lfc7/drameBOX/export/drameBOX_sch.pdf

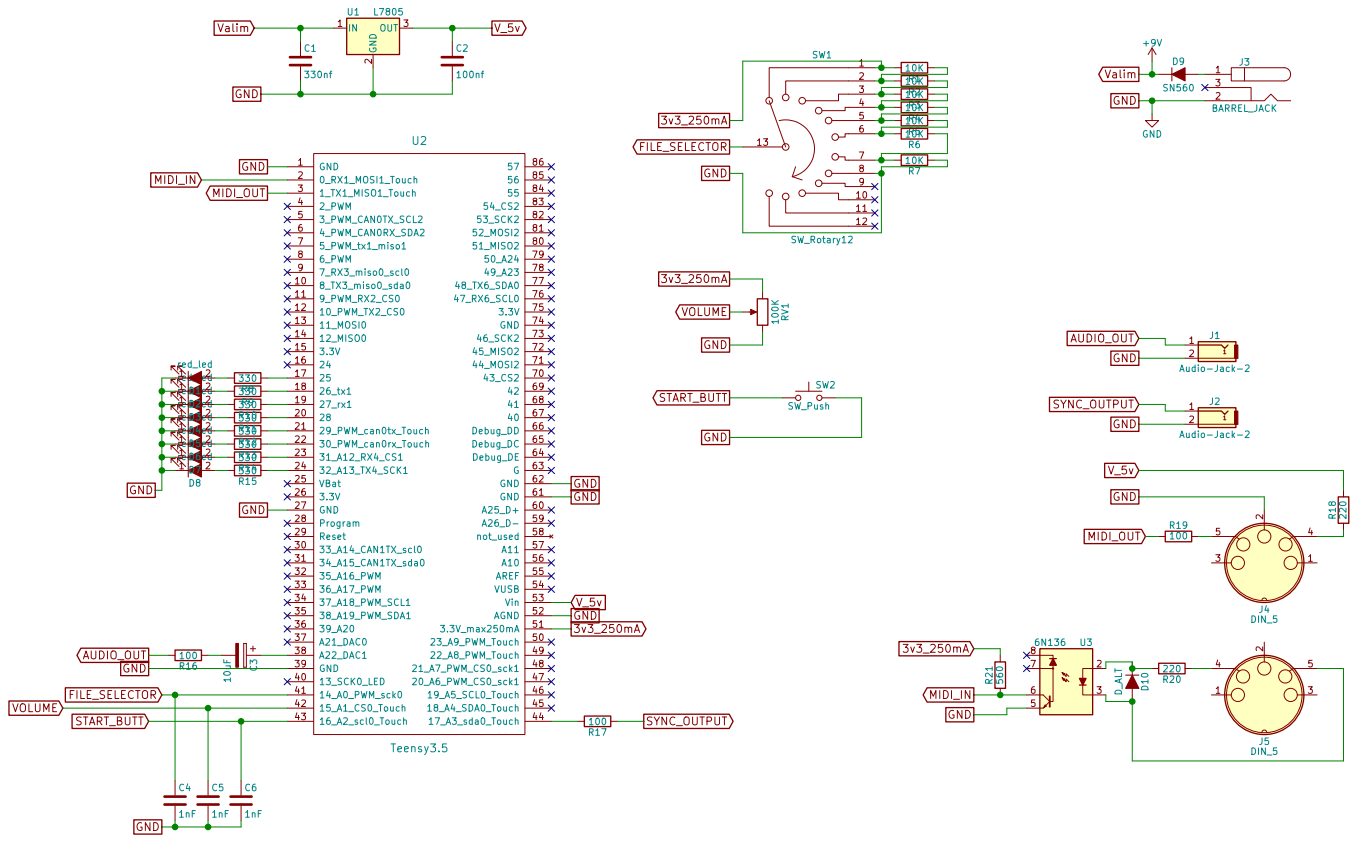
[picture p2: page 1]
