lfc7/drameBOX/(commit log)

2018-02-27 Add files via upload
    schematic
2018-03-11 Add files via upload
    change some led behaviour, invert selector
    [drameBOX.ino]
2018-03-11 Update README.md
    add schematic link
